vincentcayadi/eleclib/3dmodels/SM04B-SRSS-TB.step

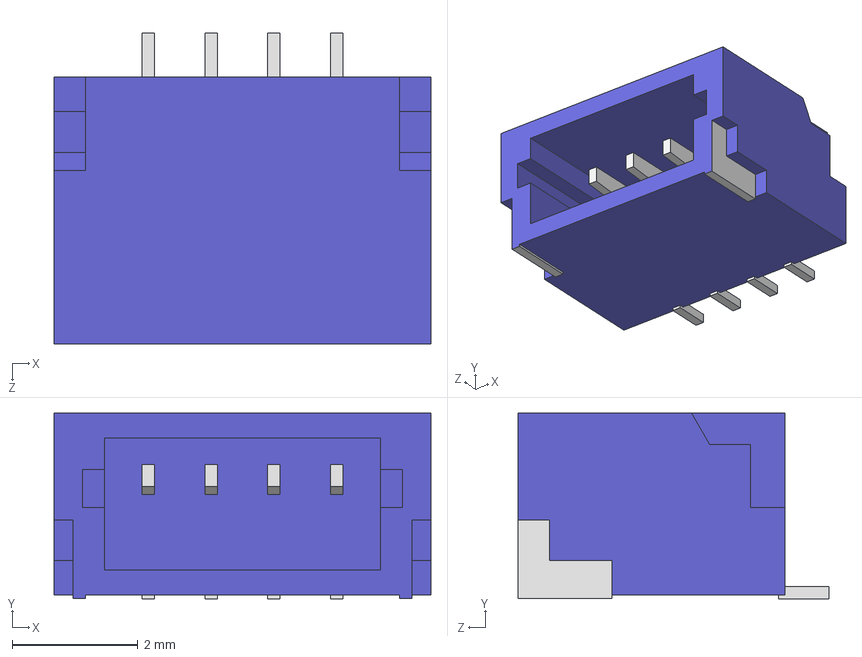
[picture p1: CAD file, 2023-05-24]
3dmodels/SM04B-SRSS-TB.step
6.00 x 2.96 x 4.95 mm
