vincentcayadi/eleclib/3dmodels/boost.step

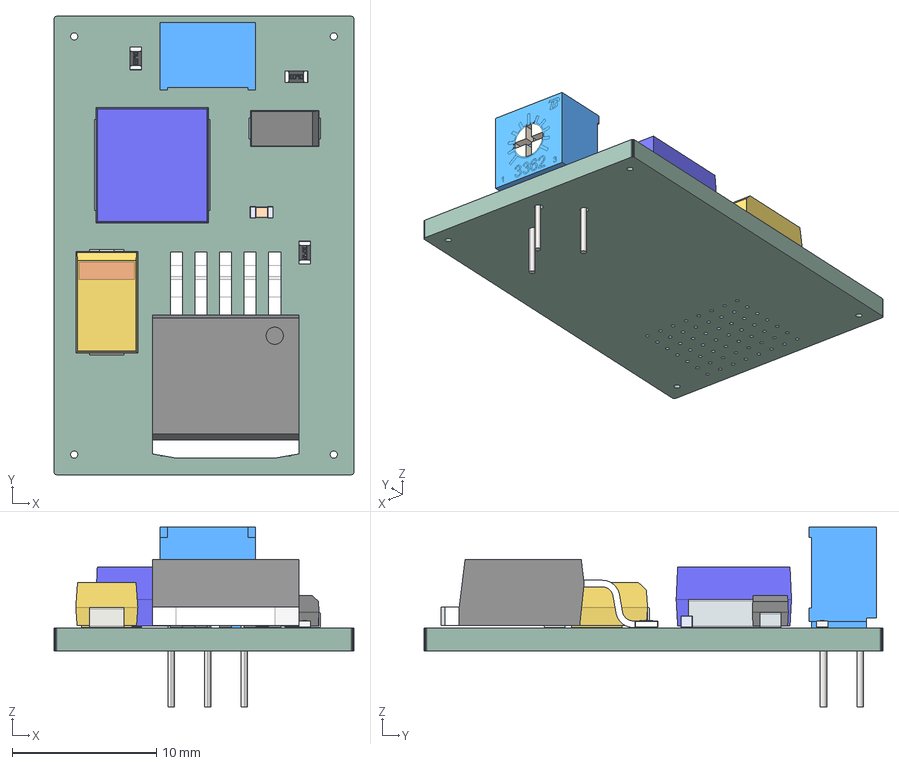
[picture p2: CAD file, 2023-05-24]
3dmodels/boost.step
20.8 x 31.8 x 12.5 mm
2023boost-int PCB
