vincentcayadi/eleclib/3dmodels/buck.step

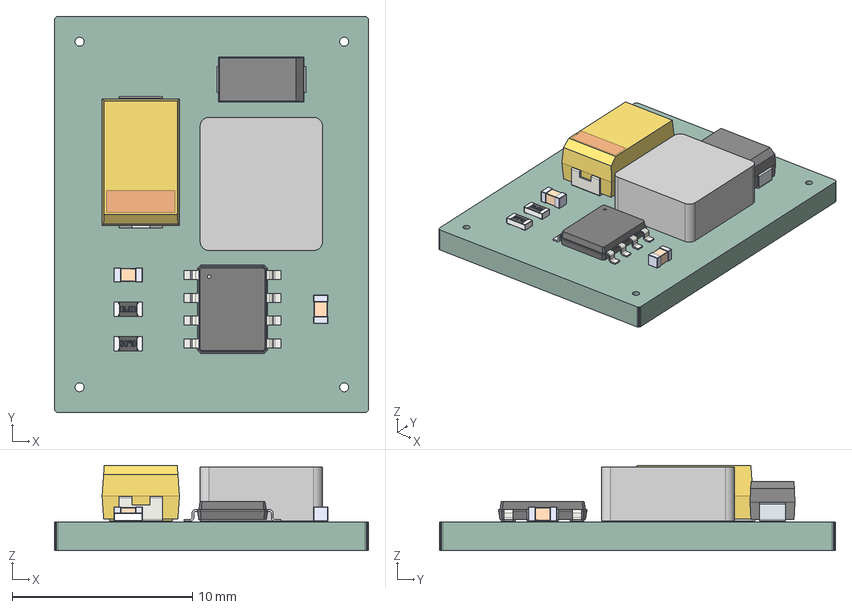
[picture p3: CAD file, 2023-05-24]
3dmodels/buck.step
17.5 x 22.0 x 4.73 mm
_autosave-tps5430 PCB
