vincentcayadi/eleclib/3dmodels/0603Inductor.step

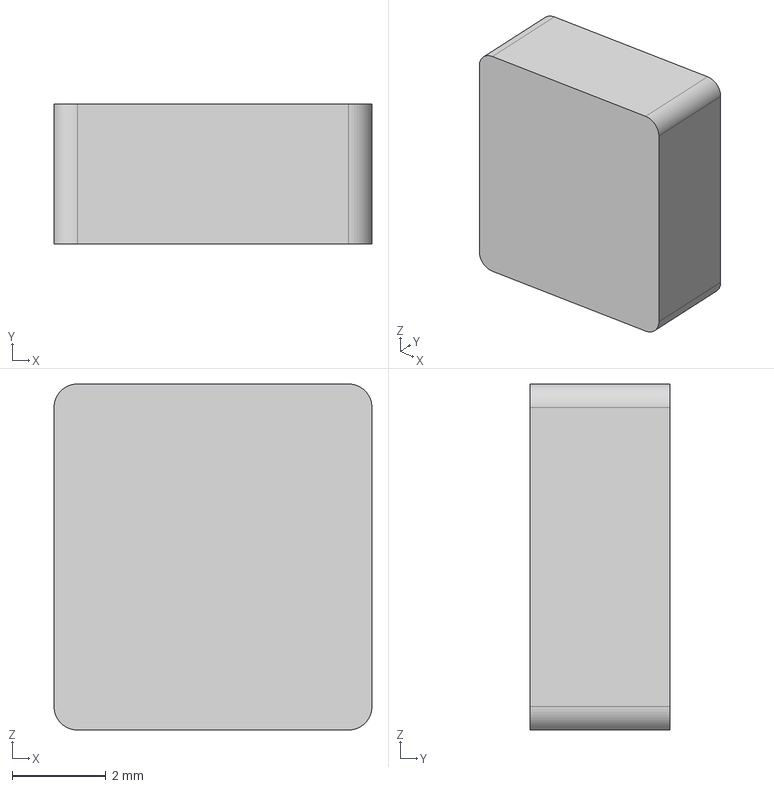
[picture p4: CAD file, 2023-05-24]
3dmodels/0603Inductor.step
6.80 x 3.00 x 7.40 mm
