vincentcayadi/eleclib/3dmodels/3362W.stp

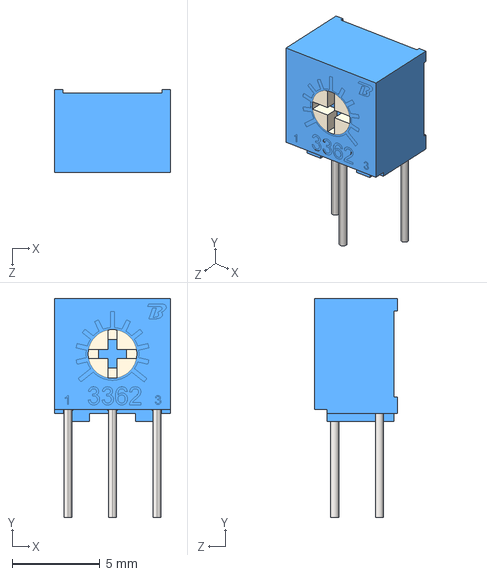
[picture p5: CAD file, 2023-05-12]
3dmodels/3362W.stp
6.60 x 12.4 x 4.70 mm
