vincentcayadi/eleclib/3dmodels/Crystal 8Mhz.step

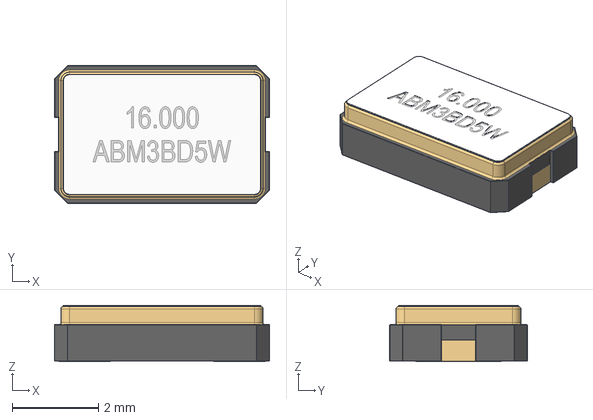
[picture p6: CAD file, 2023-05-12]
3dmodels/Crystal 8Mhz.step
5.00 x 3.20 x 1.31 mm
