vincentcayadi/eleclib/3dmodels/SW_PUSH_SPST.step

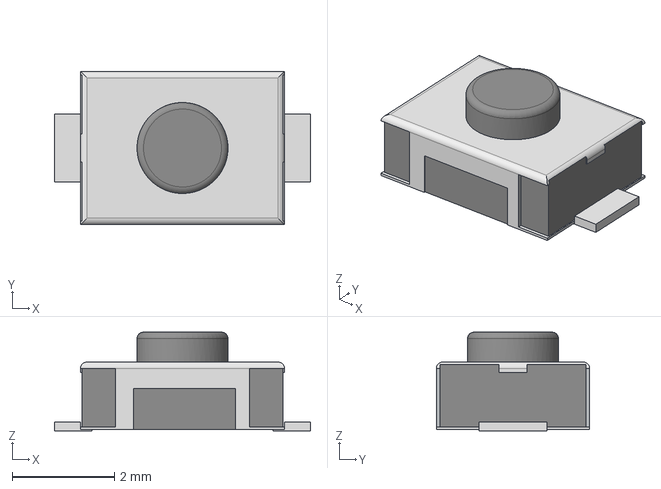
[picture p7: CAD file, 2023-05-12]
3dmodels/SW_PUSH_SPST.step
5.00 x 3.00 x 1.93 mm
