vincentcayadi/eleclib/3dmodels/SWPA8040S100MT.stp

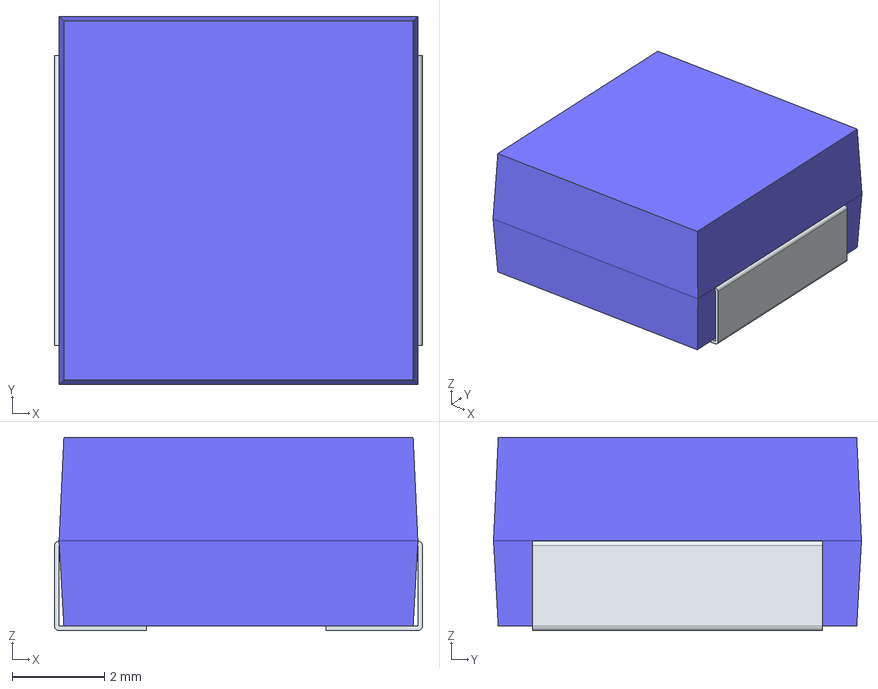
[picture p8: CAD file, 2023-05-12]
3dmodels/SWPA8040S100MT.stp
8.00 x 8.00 x 4.20 mm
FilletPin1
FilletPin2
