vincentcayadi/eleclib/3dmodels/led0603.step

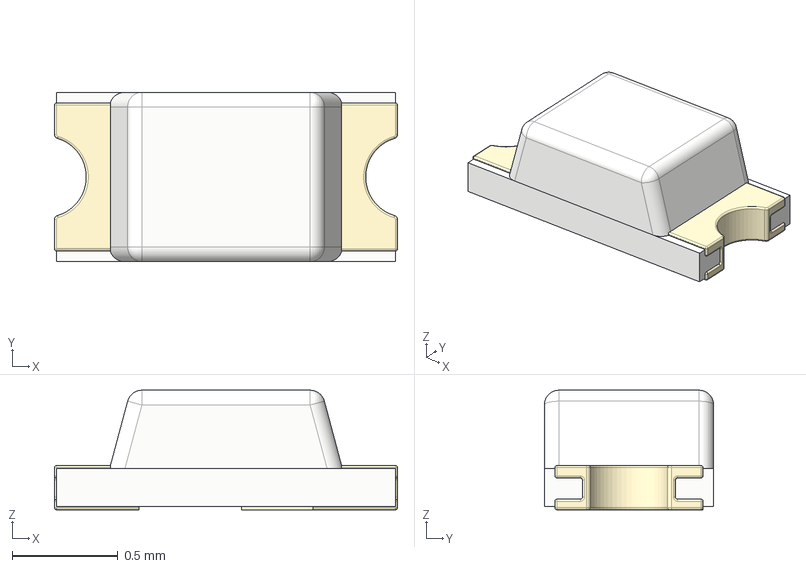
[picture p9: CAD file, 2023-05-05]
3dmodels/led0603.step
1.62 x 0.8 x 0.565 mm
Cover
Cover_Mini
Insides
