vincentcayadi/eleclib/3dmodels/VNH5050A-E.step

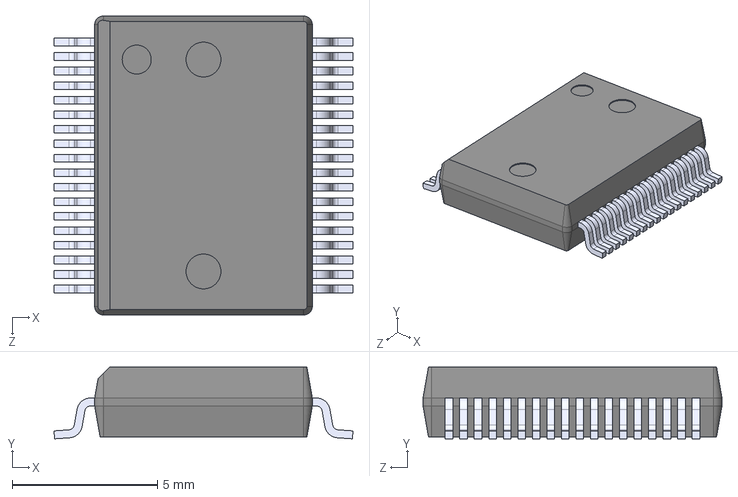
[picture p10: CAD file, 2023-05-05]
3dmodels/VNH5050A-E.step
10.3 x 2.47 x 10.3 mm
