vincentcayadi/eleclib/3dmodels/LM2587S-3.3.stp

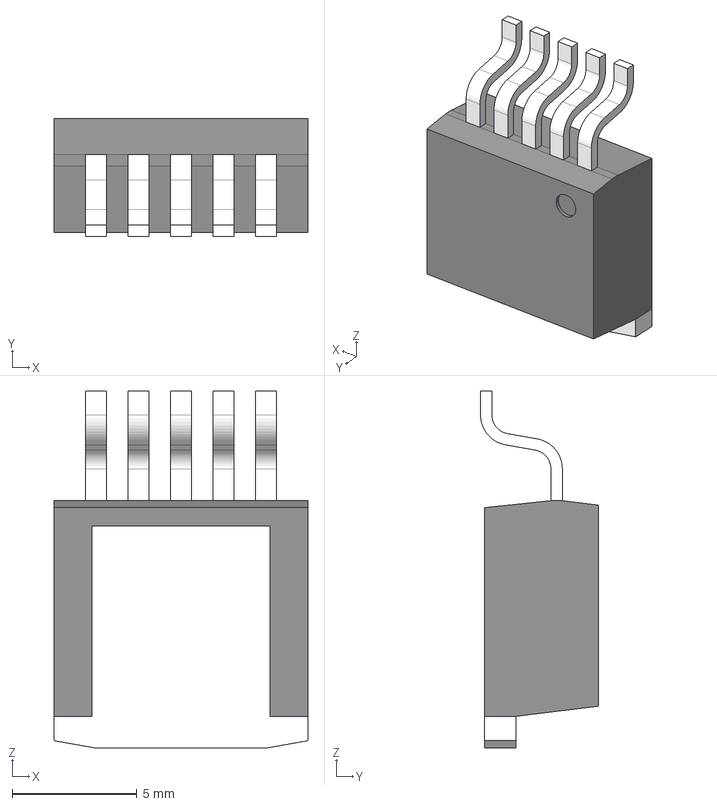
[picture p11: CAD file, 2023-05-05]
3dmodels/LM2587S-3.3.stp
10.2 x 4.72 x 14.3 mm
BODY_TS5B
HTSINK_TS5B
LEAD_TS5B x 5
