vincentcayadi/eleclib/3dmodels/XT60UPB-M.step

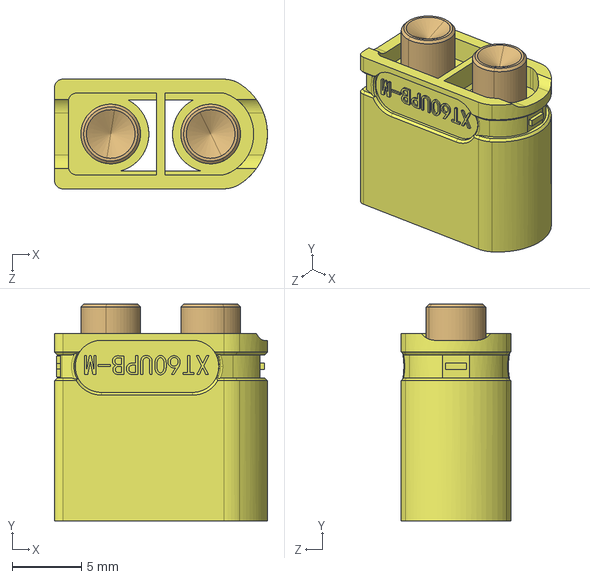
[picture p13: CAD file, 2023-05-05]
3dmodels/XT60UPB-M.step
15.3 x 15.6 x 7.90 mm
XT60UPB-M呿璃-UL
60UPB-MTJ x 2
