vincentcayadi/eleclib/3dmodels/LED3528SMD..step

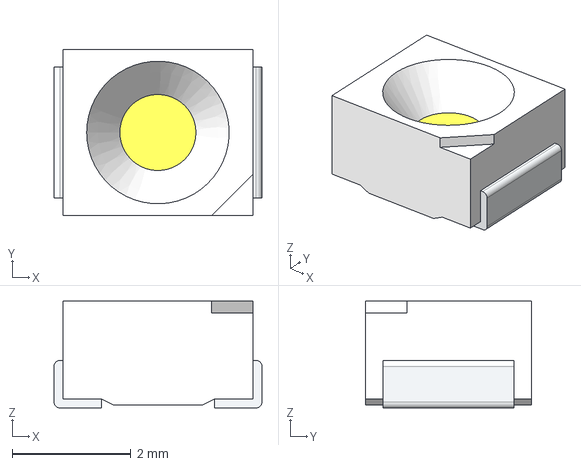
[picture p14: CAD file, 2023-05-05]
3dmodels/LED3528SMD..step
3.50 x 2.80 x 1.80 mm
