vincentcayadi/eleclib/3dmodels/C0603.STEP

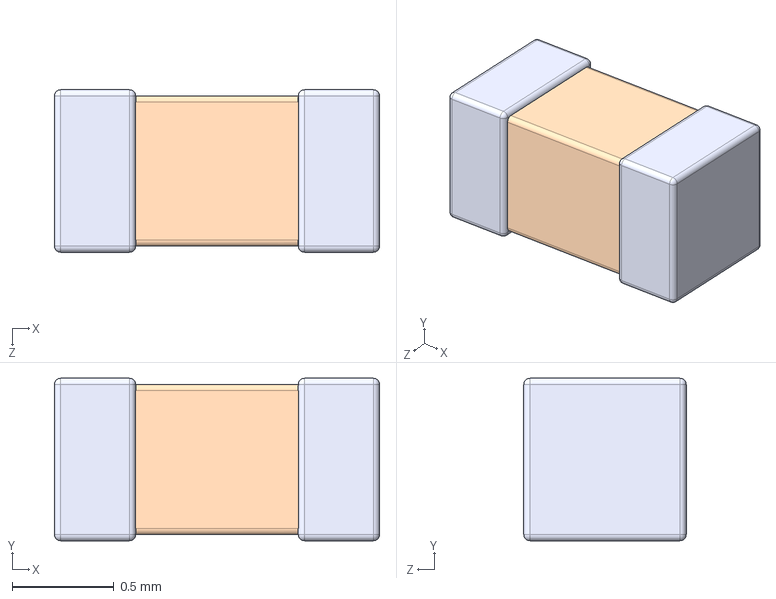
[picture p15: CAD file, 2023-05-05]
3dmodels/C0603.STEP
1.60 x 0.8 x 0.8 mm
