vincentcayadi/eleclib/3dmodels/SOT95P240X110-6L.step

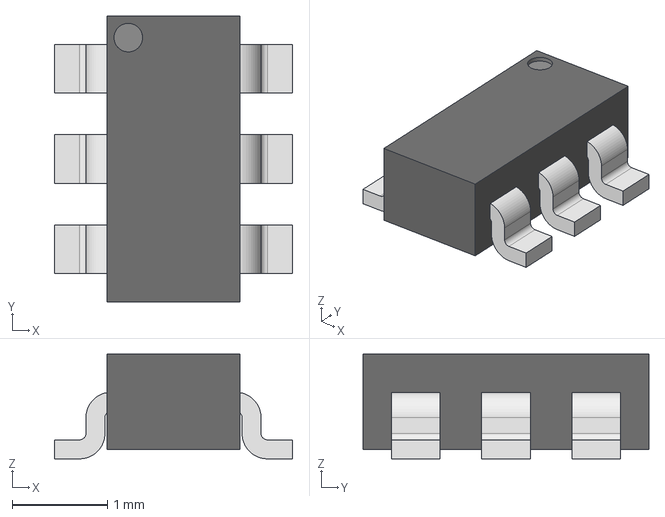
[picture p16: CAD file, 2023-05-05]
3dmodels/SOT95P240X110-6L.step
2.50 x 3.00 x 1.10 mm
