vincentcayadi/eleclib/3dmodels/SeeedStudio ESP32-C3 THT.step

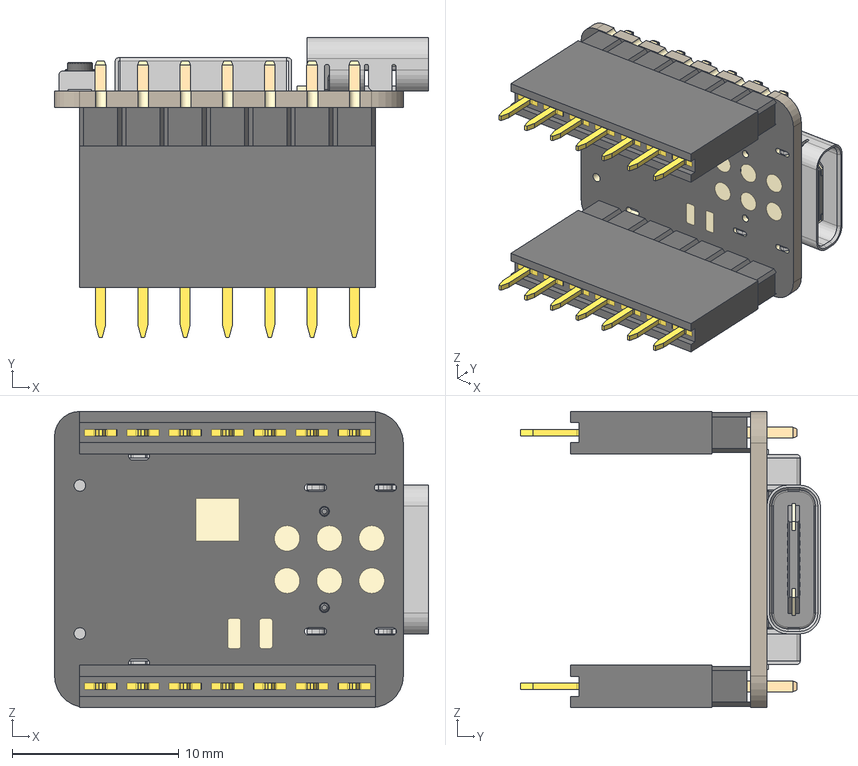
[picture p17: CAD file, 2023-05-05]
3dmodels/SeeedStudio ESP32-C3 THT.step
22.5 x 18.0 x 17.8 mm
BOSS-EXTRUDE14_8_
BOSS-EXTRUDE7_4_
BOSS-EXTRUDE7_3_
BOSS-EXTRUDE14_4_
BOSS-EXTRUDE14_2_
BOSS-EXTRUDE14_11_
BOSS-EXTRUDE7_7_
BOSS-EXTRUDE14_9_
BOSS-EXTRUDE14_3_
BOSS-EXTRUDE14_7_
MIRROR2
BOSS-EXTRUDE14_5_
BOSS-EXTRUDE14_12_
BOSS-EXTRUDE7_8_
BOSS-EXTRUDE7_1_
BOSS-EXTRUDE14_10_
BOSS-EXTRUDE7_9_
BOSS-EXTRUDE14_6_
BOSS-EXTRUDE14_1_
BOSS-EXTRUDE7_6_
BOSS-EXTRUDE7_2_
CUT-EXTRUDE5
BOSS-EXTRUDE7_5_
U.FL Connector v1
Button (1) x 2
Shield
PBS-7
PBS-7 v1(Mirror)
1_Male_Pin_2.54_mm x 7
1_Male_Pin_2.54_mm_1 x 7
