vincentcayadi/eleclib/3dmodels/SS12D00G3.stp

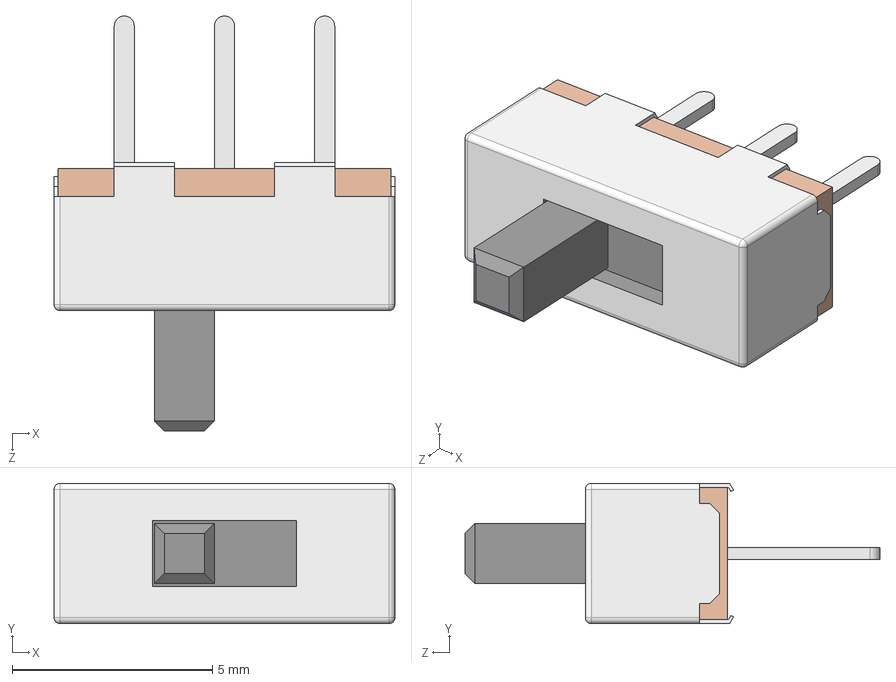
[picture p18: CAD file, 2023-05-05]
3dmodels/SS12D00G3.stp
8.50 x 3.50 x 10.3 mm
