vincentcayadi/eleclib/3dmodels/XT30UPB-F.step

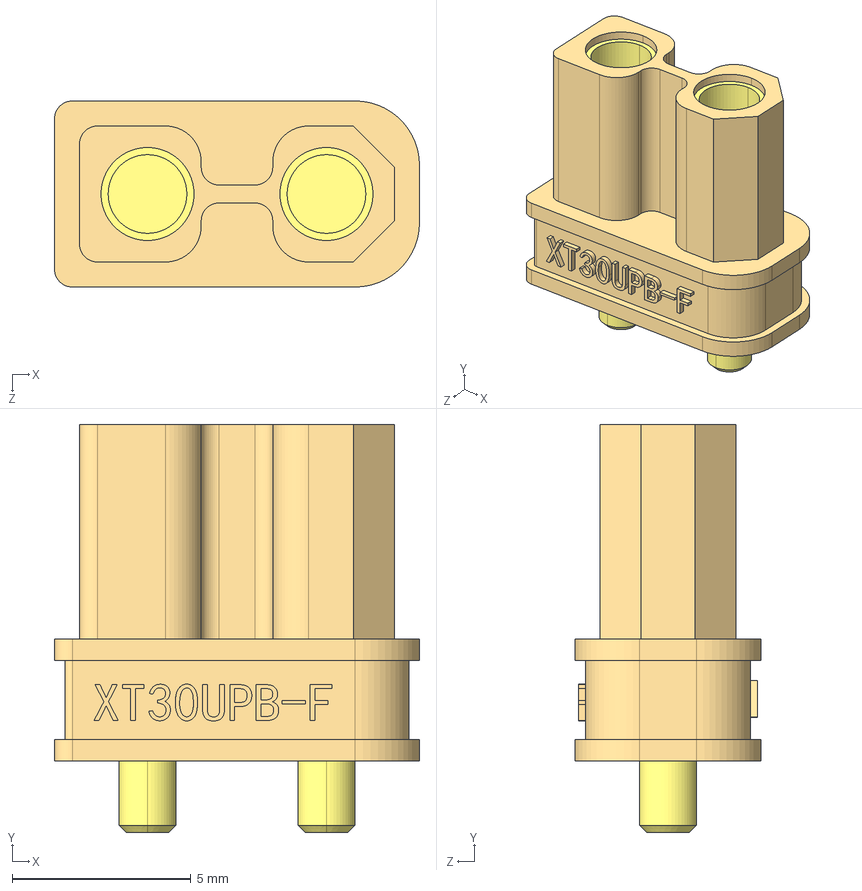
[picture p19: CAD file, 2023-05-05]
3dmodels/XT30UPB-F.step
10.2 x 11.4 x 5.20 mm
