vincentcayadi/eleclib/3dmodels/DEV-15583.step

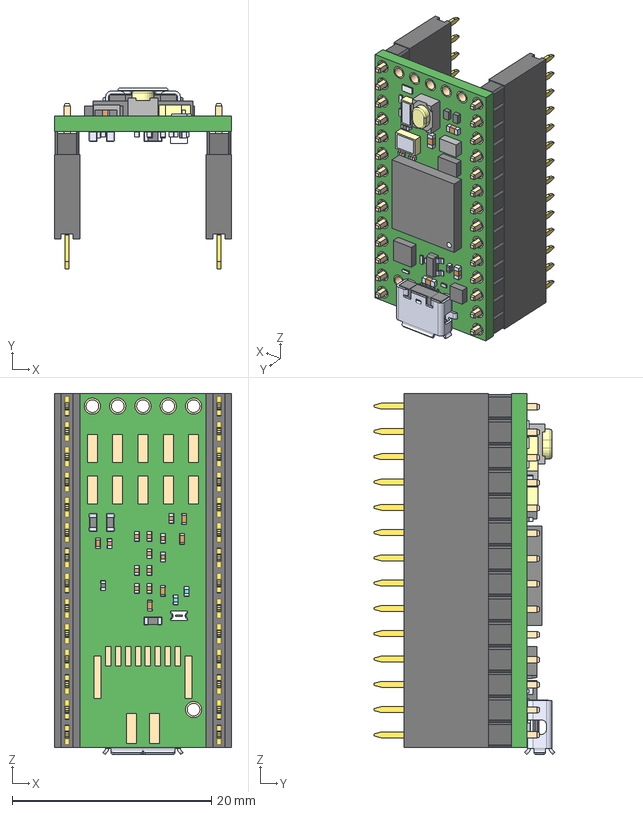
[picture p20: CAD file, 2023-05-05]
3dmodels/DEV-15583.step
17.8 x 18.2 x 36.3 mm
DEV-15583 board
C5-C18 (0.55mm)
C20-C24 (0.65)
R1-R3 (0.4inch)_1269AS-H-3R3M=P2
L1^DEV-15583 ASS
C x 2
C2
PBS-14 x 2
1_Male_Pin_2.54_mm x 28
