vincentcayadi/eleclib/3dmodels/STP75NF75.step

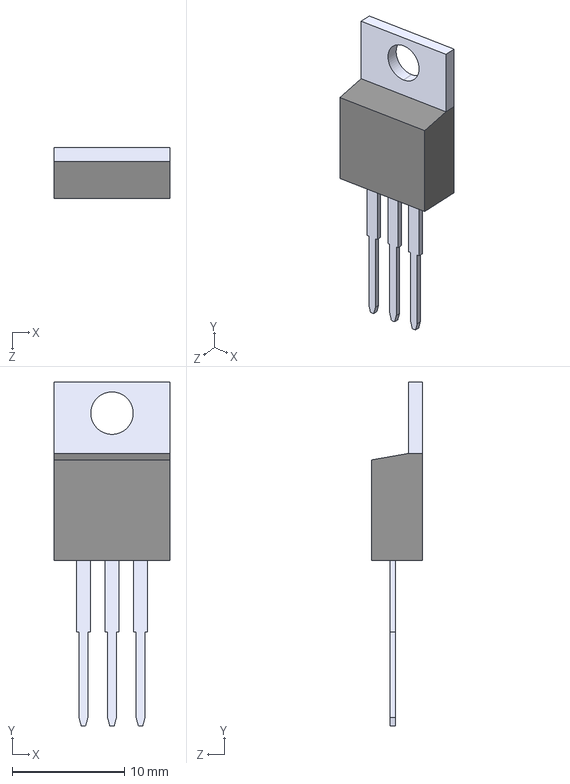
[picture p21: CAD file, 2023-05-05]
3dmodels/STP75NF75.step
10.3 x 30.6 x 4.57 mm
