vincentcayadi/eleclib/3dmodels/R0603.step

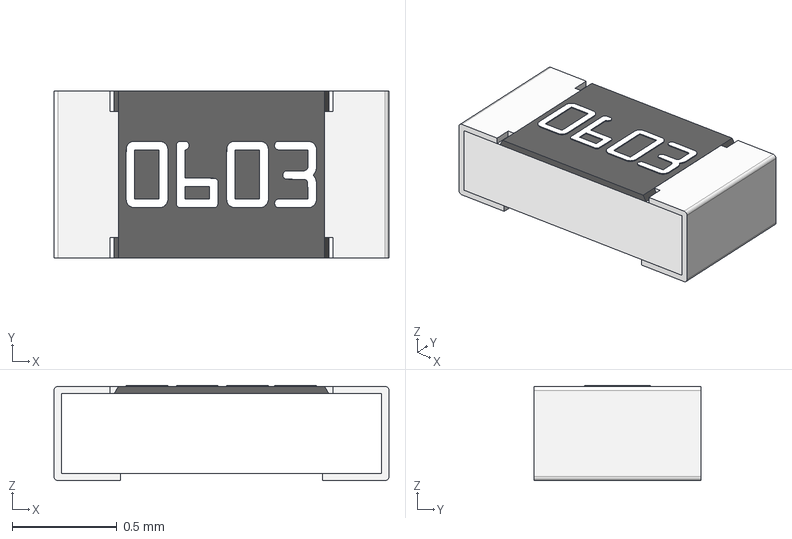
[picture p22: CAD file, 2023-05-05]
3dmodels/R0603.step
1.60 x 0.8 x 0.455 mm
Pin1Body
Pin2Body
CeramicBody
CoatingBody
Text1Body
Text2Body
Text3Body
Text4Body
