vincentcayadi/eleclib/3dmodels/PCL1C681MCL1GS.stp

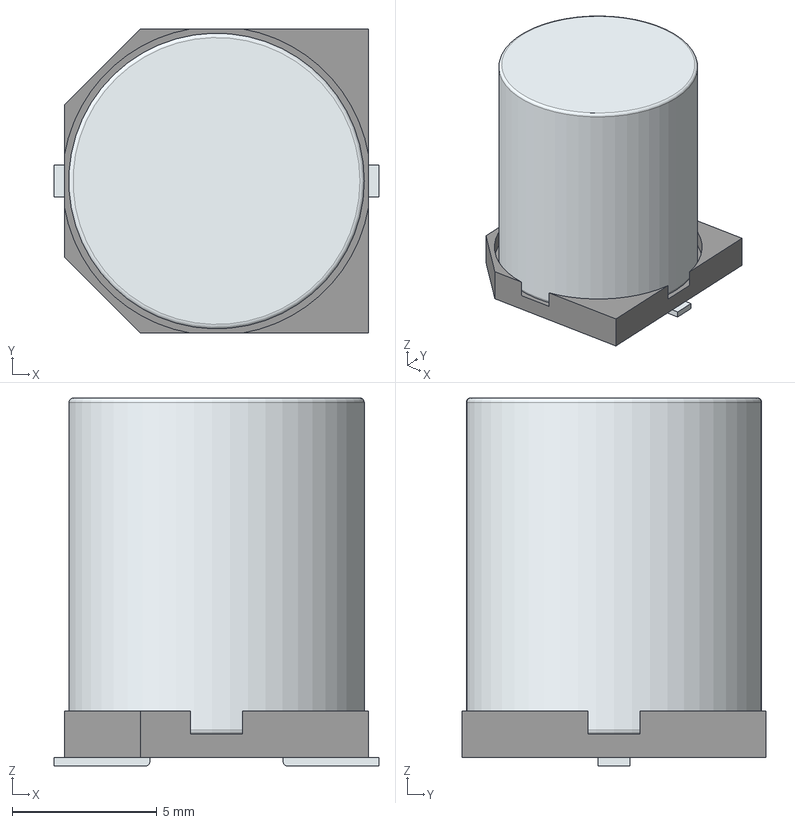
[picture p23: CAD file, 2023-05-05]
3dmodels/PCL1C681MCL1GS.stp
11.2 x 10.5 x 12.7 mm
Base
Pin1Fillet
Pin2Fillet
