vincentcayadi/eleclib/3dmodels/ALS-PT19.step

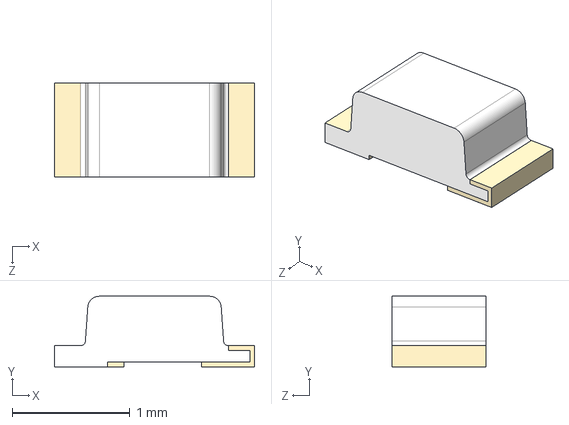
[picture p24: CAD file, 2023-05-05]
3dmodels/ALS-PT19.step
1.70 x 0.6 x 0.8 mm
