vincentcayadi/eleclib/3dmodels/SS510-HF.stp

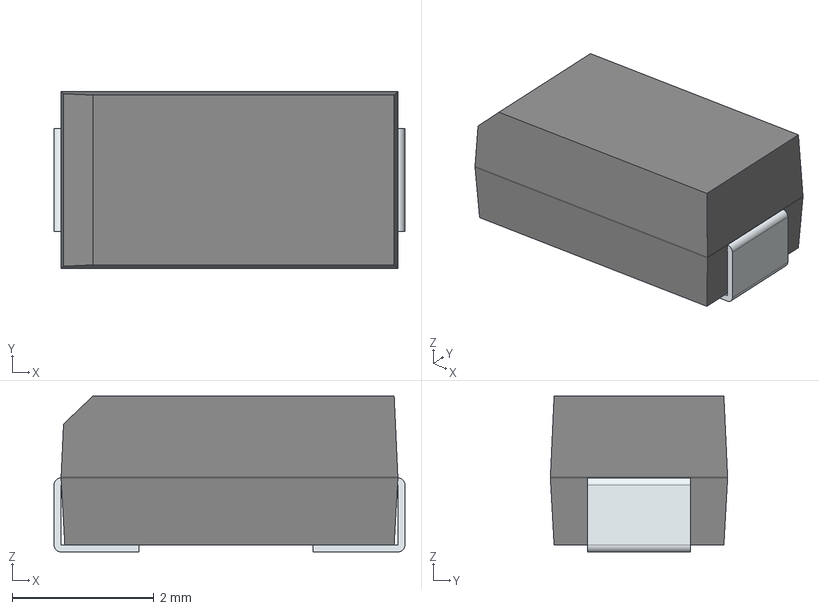
[picture p25: CAD file, 2023-05-05]
3dmodels/SS510-HF.stp
4.95 x 2.50 x 2.20 mm
FilletPin1
FilletPin2
