vincentcayadi/eleclib/(list of files, cad)

Other CAD files:
3dmodels/52271-0479.stp
3dmodels/52271-0679.stp
3dmodels/52271-1479.stp
3dmodels/52610-0633.stp
3dmodels/52610-1233.stp
3dmodels/52610-1433.stp
