vincentcayadi/eleclib/(commit log)

2022-12-27 Have to iron out mistakes
    [Schlib1.SchLib]
2022-12-27 Added missing symbols
    [Schlib1.SchLib]
2022-12-28 Modified STM32 Footprint
    [Schlib1.SchLib]
2022-12-28 Fixed MUX
    [Schlib1.SchLib]
2023-01-04 Updated LBRY
    [Schlib1.SchLib]
2023-01-04 Added JST Conns
    [Schlib1.SchLib]
2023-01-05 Added more components
    [Schlib1.SchLib]
2023-01-18 sop change
    [Schlib1.SchLib]
2023-01-18 added more shit
    [Schlib1.SchLib]
2023-01-19 Added mosfet
2023-02-02 yee yee
    [Schlib1.SchLib]
2023-02-06 new buck ic
    [Schlib1.SchLib]
2023-02-17 conn lock
    [Schlib1.SchLib]
2023-03-30 bno055 update
    [Schlib1.SchLib]
2023-05-05 migrated to kicad
    [52610-1233.stp, 52610-1433.stp, ALS-PT19.step, C0603.STEP, DEV-15583.step, LED3528SMD..step, LM2587S-3.3.stp, PCL1C681MCL1GS.stp]
2023-05-05 cleaned footprints
2023-05-18 kill me
    [52271-1479.stp]
